achyutnar/therapyDeviceFYP/Component Dimension.xlsx

(All Dimensions mentioned in mm)
Component | Length | Width | Height | Robu
Battery | 70 | 40 | 25 | Li-Ion Battery (https://robu.in/product/18650-li-ion-2500mah-7-4v-2s1p-protected-battery-pack-3c-2/)
Fabricated PCB | 70 | 50 | 2
OLED Display | 7.6 | 24.4 |  | OLED 0.91 Inch (https://robu.in/product/0-91-inch-128x32-i2c-iic-serial-blue-oled-lcd-display-module/)
Button | 6 | 6 |  | Tactile Button (https://robu.in/product/kfc-a06b-7-0-tact-switch-long-terminals-2-pin6x6x7/)
Power Button | 6 | 6 | 6 | Self Lock Switch (https://robu.in/product/self-lock-switch-kfc-5-85-8-short-head/)
Female Power Jack | Diameter : 5.5 |  |  | DC Power Jack Female (https://robu.in/product/female-2-15-5mm-for-dc-power-jack-adapter-connector-plug-for-cctv-camera/)
Female TENS Jack | Diameter : 5.5 |  |  | DC Power Jack Female (https://robu.in/product/female-2-15-5mm-for-dc-power-jack-adapter-connector-plug-for-cctv-camera/)
PTC Heater | 0 | 21 | 5 | Heating Element (https://robu.in/product/12v-ptc-heaters-heating-element-hair-dryer-accessories-curlers-heater-80-degree-celsius-air-heater/)
Vibration Motor | Diameter : 8 |  |  | Vibration motor (https://robu.in/product/erm-coin-vibration-motor-8-mm-dia-2-mm-width/)
