achyutnar/therapyDeviceFYP/Component Documentation/Nano BLE33 Rev 2/ABX00071-cad-files/Manufacturing files/BOM/Bill of Materials-NANO33BLE(ABX00071).xlsx

Fitted | Quantity | Designator | Code Arduino | Manufacturer | Part Number | Description
Fitted | 1 | C1 | 0689 | PSA Shenzen | FV21X472K102ECG | CAP CHIP 0805 4.7nF 10% 1000V X7R
Fitted | 6 | C2, C7, C8, C9, C19, C24 | A5141 | Murata | GRM155R61H104KE19D | CAP CHIP 0402 100nF 10% 50V X5R
Fitted | 4 | C3, C4, C17, C23 | 2213 | Hottech | C1608A106M250NT | CAP CHIP 0603 10uF 20% 25V X5R
Fitted | 1 | C5 | 0132 | Walsin | 0402B104K160CT | CAP CHIP 0402 100nF 10% 16V X7R
Fitted | 2 | C6, C10 | 2321 | KEMET | GRM155R71H102KA01D | CAP CHIP 0402 1nF 10% 50V X7R
Not Fitted | 0 | C11, C12, C21 | A5141 | Murata | GRM155R61H104KE19D | CAP CHIP 0402 100nF 10% 50V X5R
Not Fitted | 0 | C13 | 0165 | Hottech | C1005B103K500NT | CAP CHIP 0402 10nF 10% 50V X7R
Not Fitted | 0 | C14 | 0833 | Hottech | C1005A475M6R3NT | CAP CHIP 0402 4.7uF 20% 6V3 X5R
Not Fitted | 0 | C15, C16, C25 | 0133 | Samsung Electro-Mechanics | CL05A105KP5NNNC | CAP CHIP 0402 1uF 10% 10V X5R
Fitted | 1 | C20 | 0137 | Walsin | 0402N220J500CT | CAP CHIP 0402 22pF 5% 50V C0G
Fitted | 1 | C22 | 0133 | Samsung Electro-Mechanics | CL05A105KP5NNNC | CAP CHIP 0402 1uF 10% 10V X5R
Fitted | 1 | D1 | 2209 | Nexperia | PRTR5V0U2X,215 | TVS ARRAY 4LIN.8kV 1pF SOT143B
Fitted | 1 | D2 | 2208 | Nexperia | PMEG6020AELRX | DIODE SCHOTTKY SMD 2A 60V SOD123FL
Fitted | 1 | DL1 | 2243 | Kingbright | KPT-1608YC | LED SMD 0603 GIA588 8mcd 120^
Fitted | 1 | DL2 | 2204 | Broadcom | HSMG-C190 | LED SMD 0603 GREEN/568 15mcd 120^
Fitted | 1 | DL3 | A5469 | ROHM Semiconductor | SMLP34RGB2W3 | LED RGB DIFFUSED PICOLED SMD
Fitted | 1 | J1 | 2219 | Hirose | ZX62-AB-5PA(31) | CONN USB MICRO F/90^ SMD TipoAB 5x1
Not Fitted | 0 | JP2 | 0646 |  |  | CONN THD SOCKET F/1/D 15V JANALOG NANO-TYPE CASTELLATED
Not Fitted | 0 | JP3 | 0646 |  |  | CONN THD SOCKET F/1/D 15V JDIGITAL NANO-TYPE CASTELLATED
Fitted | 1 | L1 | A5482 | Murata | BLM18EG101TN1D | FERRITE SMD 0603 45mOHM 2A
Fitted | 1 | L2 | I0045 | Taiyo Yuden | MAKK2016T3R3M | IND CHIP 0806 3.3 uH 20% 1.2A
Fitted | 1 | PB1 | 0173 | Switronic | IT-1185AP1C-160G-GTR | PUSHBUTTON WHITE NO ANCHORS
Fitted | 1 | Q1 | 2368 | Diodes Inc. | 2N7002T-7-F | MOSFET N-CH 60V 115mA SOT523
Fitted | 1 | R1 | 0139 | Vishay | CRCW04021M00FKED | RES CHIP 0402 1M 1% 1/16W
Fitted | 2 | R2, R3 | 2229 | Vishay | CRCW0402330RJNED | RES CHIP 0402 330R 5% 1/16W
Not Fitted | 0 | R4, R5 | 2196 | YAGEO | RC0402FR-074K7L | RES CHIP 0402 4k7 1% 1/16W
Fitted | 2 | R6, R9 | R0070 | Vishay | CRCW0402976KFKED | RES CHIP 0402 976k 1% 1/16W
Fitted | 3 | R7, R11, R12 | 0140 | Vishay | CRCW04021K00FKEDC | RES CHIP 0402 1k 1% 1/16W
Fitted | 1 | R8 | 2334 | Vishay | CRCW0402220KFKED | RES CHIP 0402 220k 1% 1/16W
Fitted | 2 | R13, R14 | 2196 | YAGEO | RC0402FR-074K7L | RES CHIP 0402 4k7 1% 1/16W
Not Fitted | 0 | R15 | 0468 | YAGEO | RC0402FR-0722RL | RES CHIP 0402 22R 1% 1/16W
Fitted | 4 | SJ1, SJ2, SJ3, SJ5 | This is not a component |  |  | Solder Jumper 0805 THIS IS NOT A COMPONENT
Fitted | 1 | SJ4 |  |  |  | Solder Jumper shorted pads. This is not a component
Fitted | 1 | U1 | NINA-B306 | UBlox | NINA-B306 | MODULE BLE 5.0 STAND ALONE nRF52
Fitted | 1 | U2 | U0217 | Bosch Sensortec | BMI270 | IC IMU 6 AXIS 14VFLGA pin to pin alternative to LSM6DSOXTR
Not Fitted | 0 | U3 | A5470 | ST Microelectronics | MP34DT06JTR | SENS MEMS AUDIO OMNIDIRECTIONAL
Not Fitted | 0 | U4 | U0034 | Microchip | ATECC608A-MAHDA-T | IC AUTHENTICATION CHIP UDFN8
Not Fitted | 0 | U5 | A5475 | Broadcom | APDS-9960 | IC SENS OPT 560NM AMBIENT MODULE APDS-9960
Fitted | 1 | U6 | U0072 | Monolithic Power Systems | MP2322GQH | IC STEP DOWN CONV 1A 22V QFN8
Fitted | 1 | U7 | U0153 | Bosch Sensortec | BMM150 | IC SENSOR 3-AXIS GEOMAGNETIC
Not Fitted | 0 | U8 | U0253 | Renesas | HS3003 | IC PRESSURE AND TEMPERATURE SENSOR 6-LGA
Not Fitted | 0 | U9 | A5390 | ST Microelectronics | LPS22HBTR | SENSOR PRESSURE 3.77 PSI ~ 18.27 PSI (26 kPa ~ 126 kPa) Absolute 24 b 10-WFLGA
