achyutnar/therapyDeviceFYP/Research Papers and Documents/Device Controller App Design.pdf

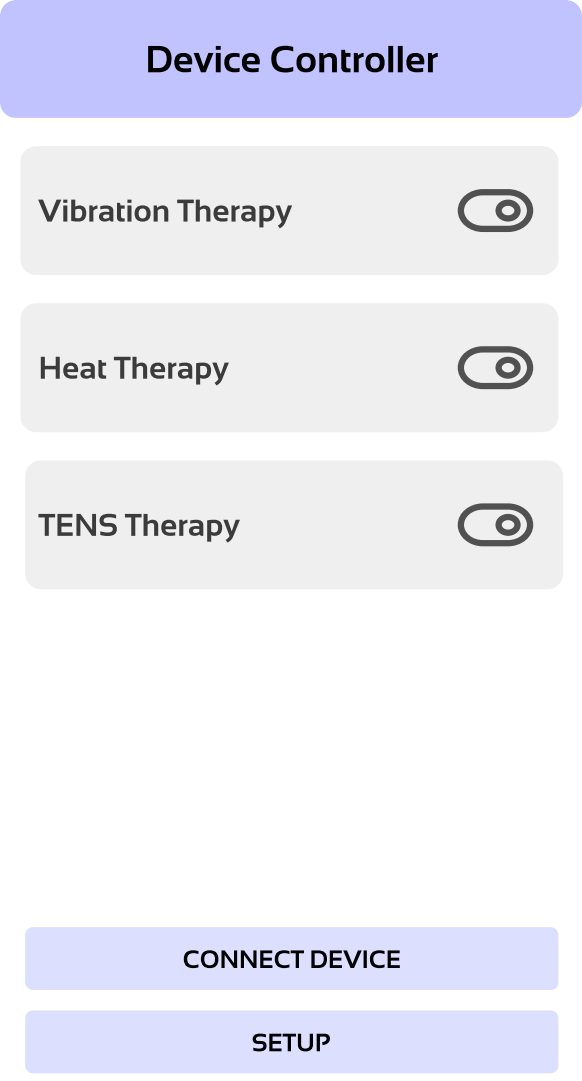
[picture p39: page 1]
Device Controller; CONNECT DEVICE; SETUP

## Device Setup

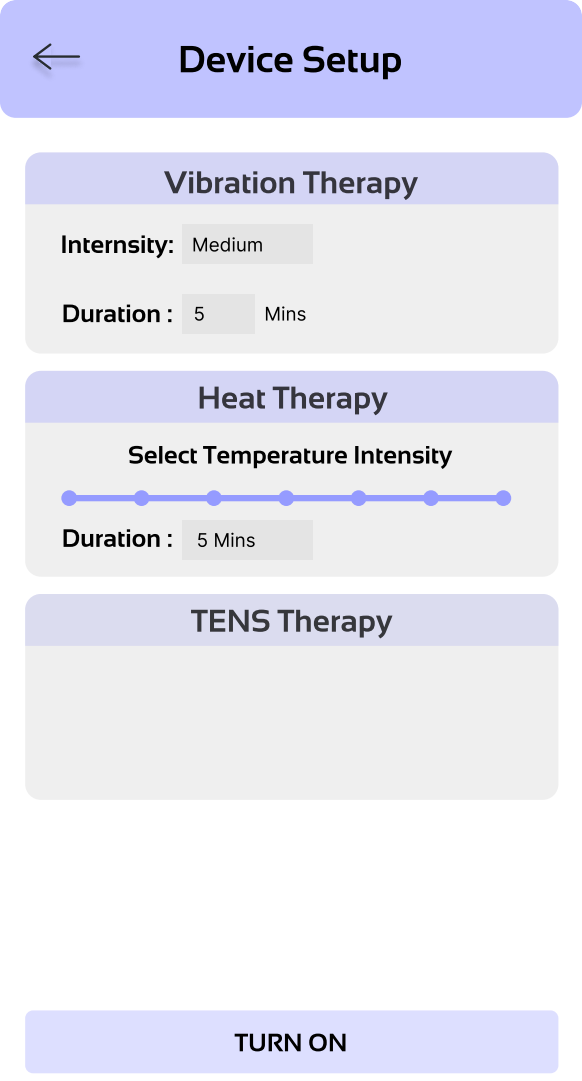
[picture p40: page 2]
TURN ON; Mins; Duration :; 5 Mins; Internsity:; Medium

Select Temperature Intensity
