achyutnar/therapyDeviceFYP/Research Papers and Documents/The emerging role of focal muscle vibration in rehabilitation of neurological.pdf

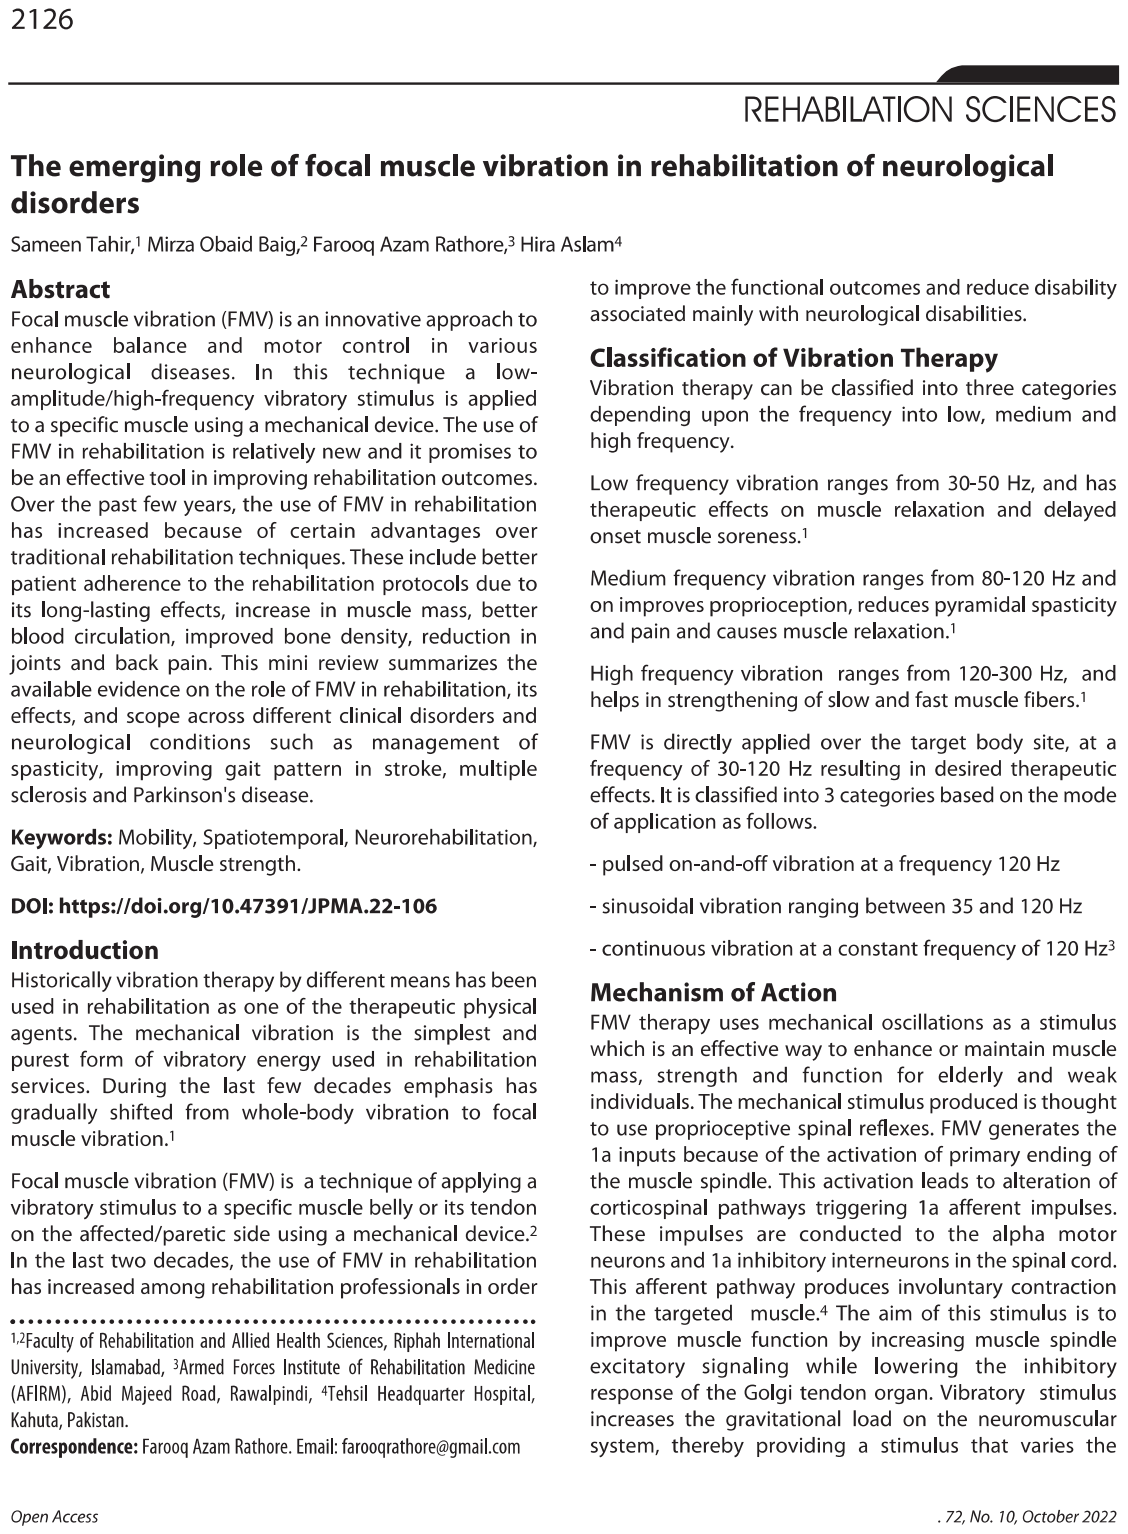
[picture p45: page 1]

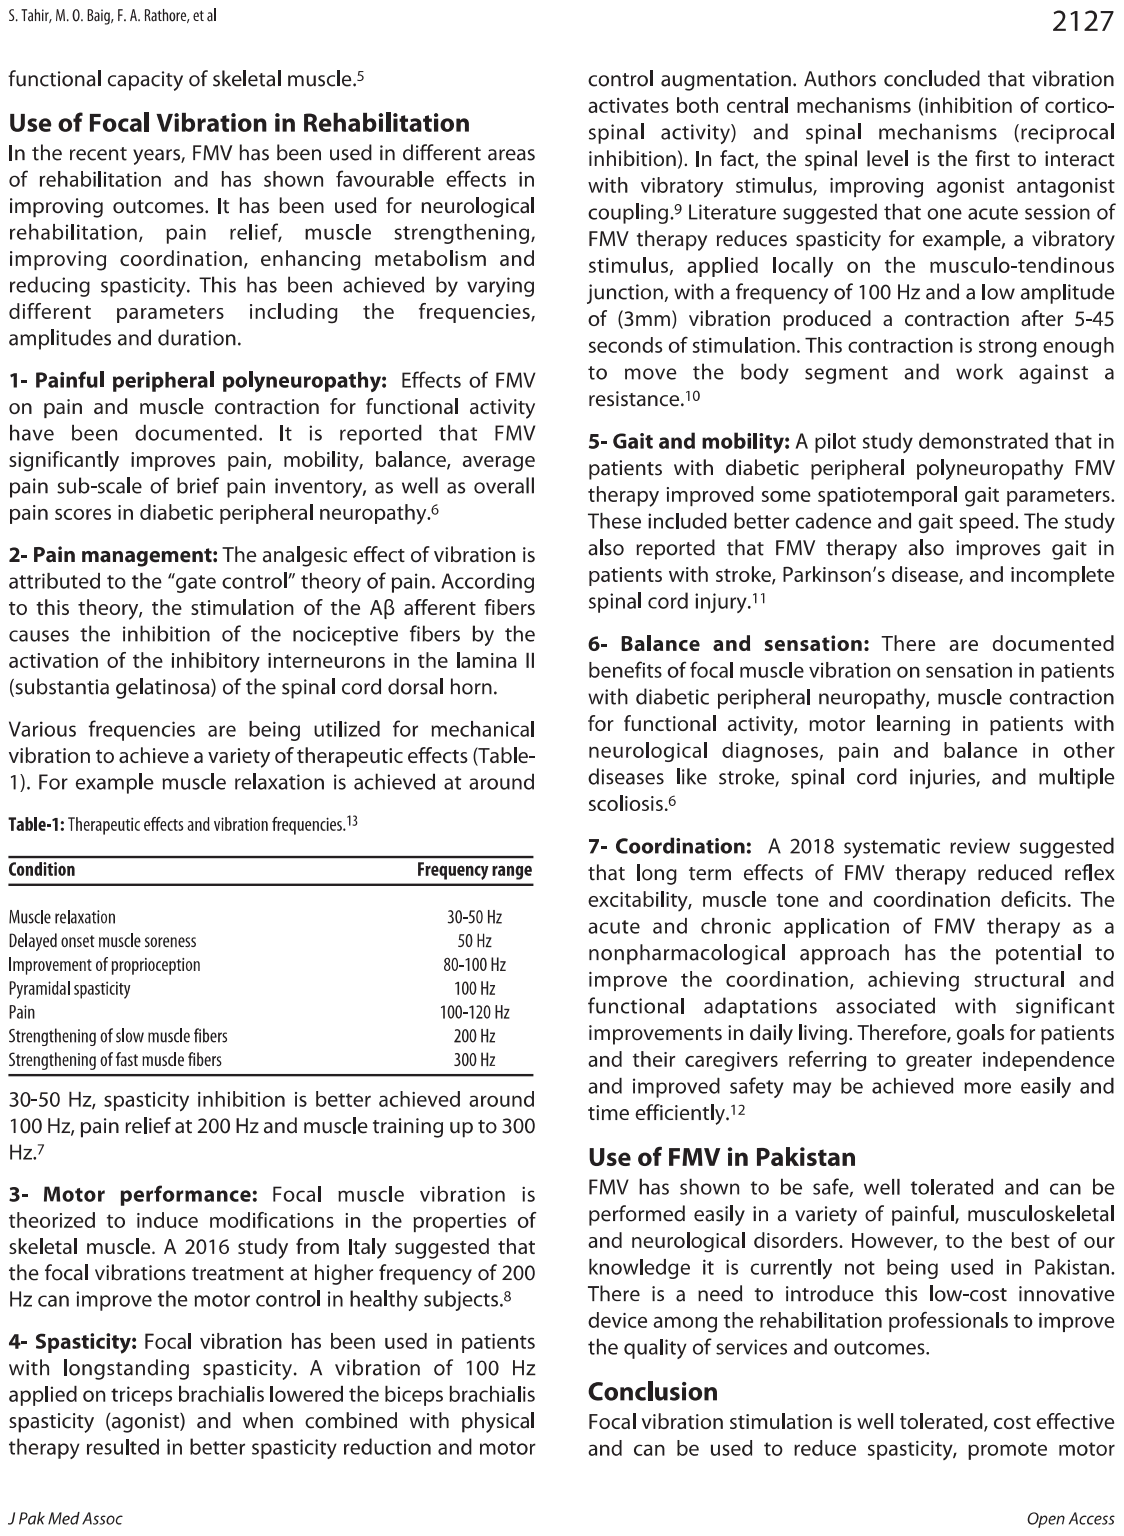
[picture p46: page 2]

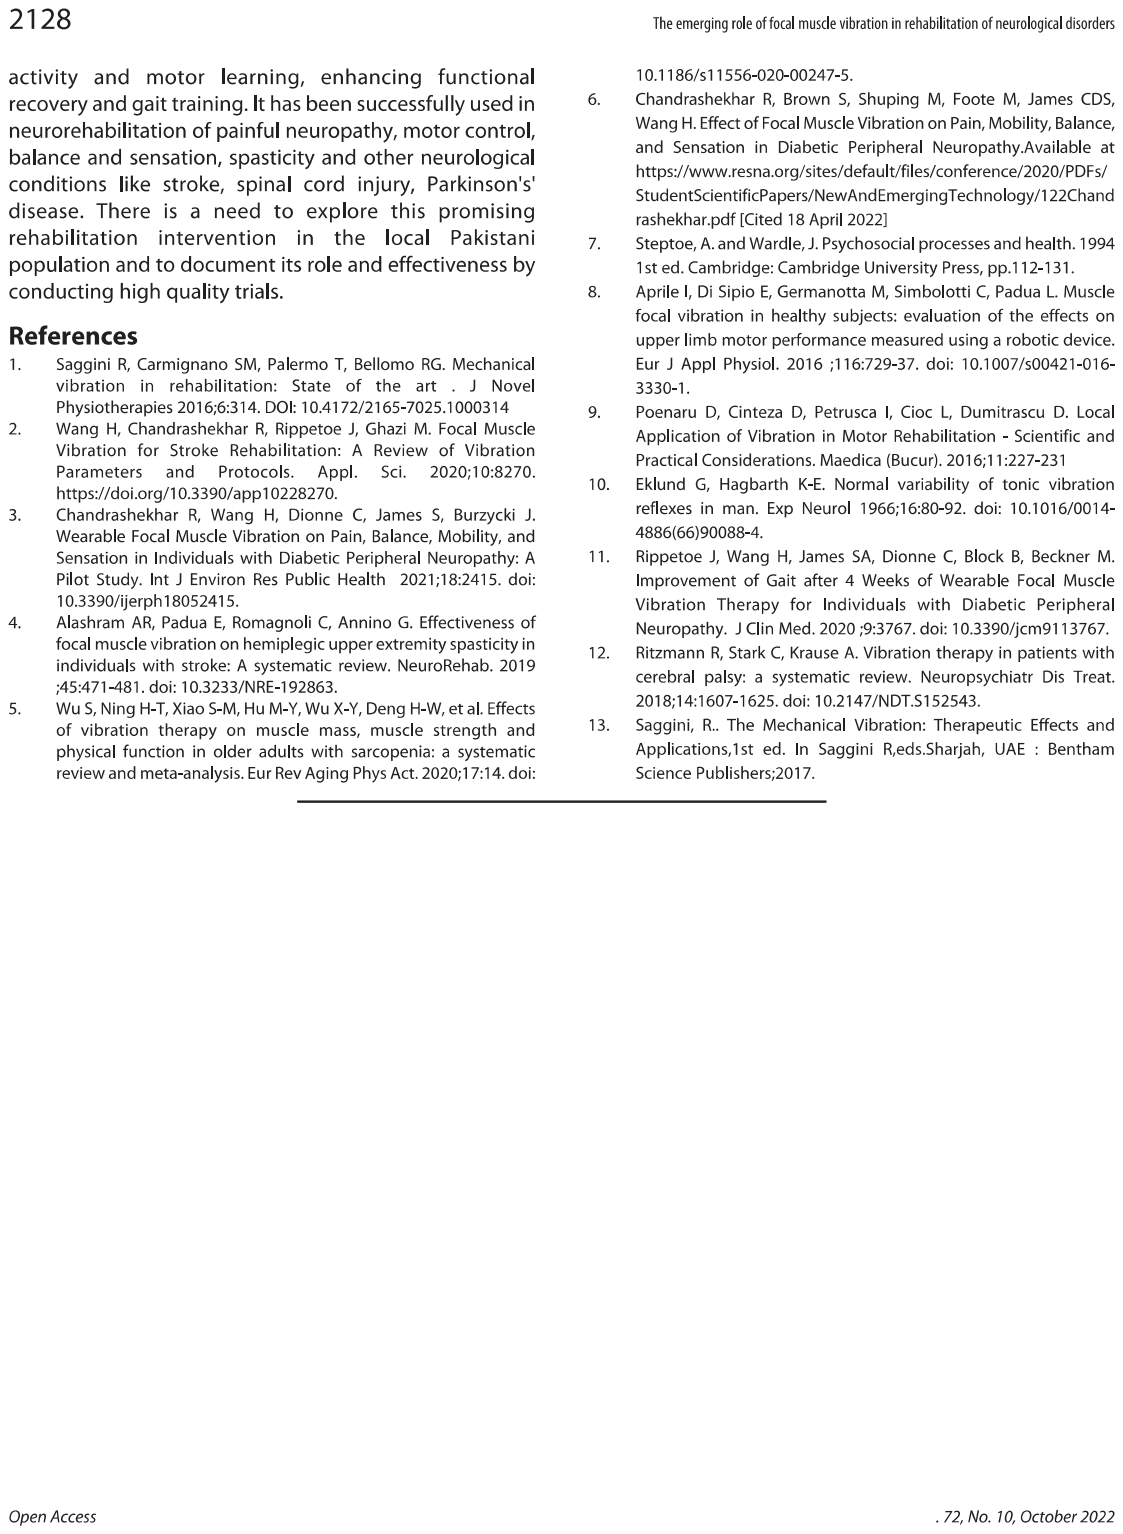
[picture p47: page 3]
