achyutnar/therapyDeviceFYP/(list of files, drawings)

Other design files:
Component Documentation/Nano BLE33 Rev 2/ABX00071-cad-files/Altium files/NANO33BLE.PcbDoc
Component Documentation/Nano BLE33 Rev 2/ABX00071-cad-files/Altium files/NANO33BLE.SchDoc
Component Documentation/Nano BLE33 Rev 2/ABX00071-cad-files/Altium files/NANOBLE.PrjPcb
