achyutnar/therapyDeviceFYP/PCB Design/VibAndHeat_Version1/VibAndHeat_Version1.kicad_pcb

## KiCad design PCB Design/VibAndHeat_Version1/VibAndHeat_Version1.kicad_pcb (2025-05-12)

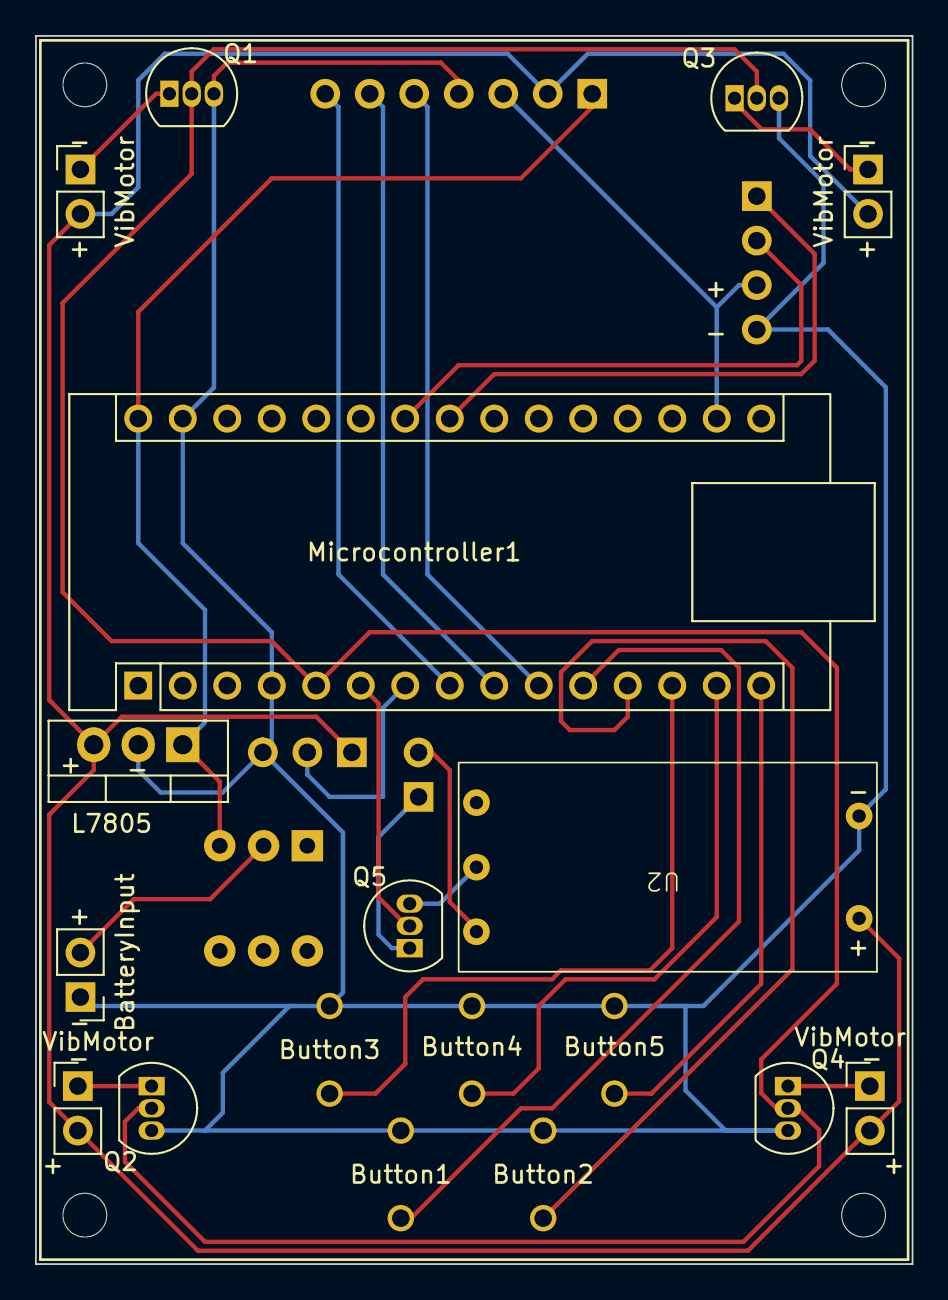
[picture p48: board VibAndHeat_Version1.kicad_pcb from above]

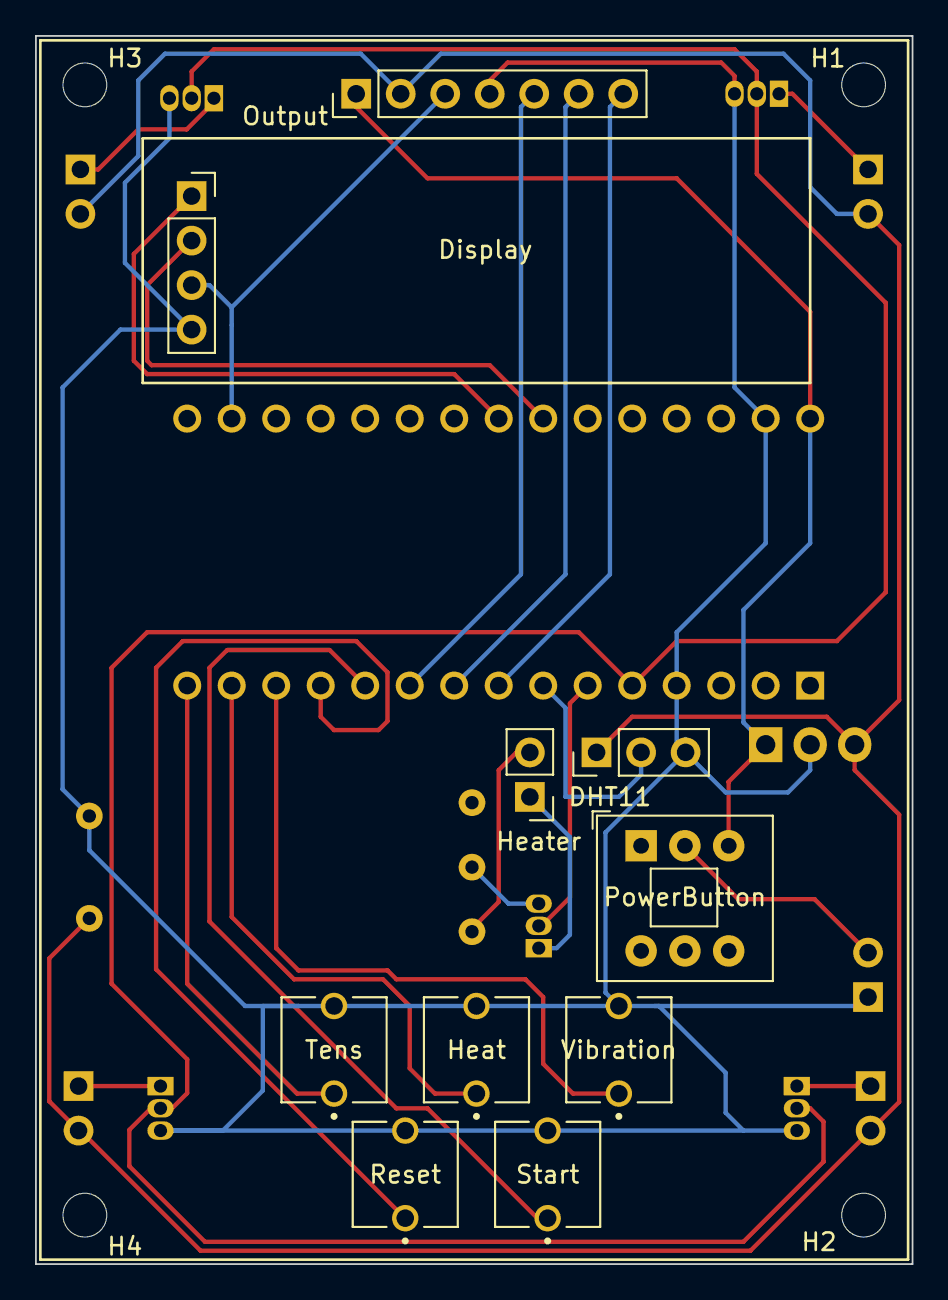
[picture p49: board VibAndHeat_Version1.kicad_pcb from below]

Board: 2 copper layers, 50.0 x 70.1 mm, 27 parts (14 on the bottom side), 25 nets.

Parts:
Button1: Start; Button_Push_2pin
Button2: Reset; Button_Push_2pin
Button3: Vibration; Button_Push_2pin
Button4: Heat; Button_Push_2pin
Button5: Tens; Button_Push_2pin
H1, H2, H3, H4: MountingHole; MountingHole_2.5mm
J1, J2, J3, J4: VibMotor; PinHeader_1x02_P2.54mm_Vertical
J5: Heater; PinHeader_1x02_P2.54mm_Vertical
J6: BatteryInput; PinHeader_1x02_P2.54mm_Vertical
J7: Display; PinSocket_1x04_P2.54mm_Vertical
J8: Output; PinHeader_1x07_P2.54mm_Vertical
Microcontroller1: Nano BLE33; Arduino_Nano
Q1, Q2, Q3, Q4, Q5: 2N2222; TO-92_Inline
SW1: PowerButton; SW_Push_2P2T_Toggle_CK_PVA2OAH5xxxxxxV2
U1: DHT11; PinHeader_1x03_P2.54mm_Vertical
U2: Step_up_Convertor_12v
U3: L7805; TO-220-3_Vertical

Connections:
GND: Button1.2, Button2.2, Button3.2, Button4.2, Button5.2, J6.1, J7.4, J8.4, Microcontroller1.4 (GND), Microcontroller1.29 (GND), Q1.3 (C), Q2.3 (C), Q3.3 (C), Q4.3 (C), U1.3 (GND), U2.2 (GND1), U3.2 (GND)
HT-Heater: Microcontroller1.6 (D3), Q5.2 (B)
HT-Sensor: Microcontroller1.7 (D4), U1.2 (IO)
Input_5v: J1.2, J2.2, J3.2, J4.2, J8.2, U1.1 (VCC), U2.1 (VIN), U3.3 (OUT)
Input_7v4: J8.1, Microcontroller1.30 (VIN), SW1.3 (C), U3.1 (IN)
unnamed: J1.1, Q1.1 (E)
unnamed: J2.1, Q2.1 (E)
unnamed: J3.1, Q3.1 (E)
unnamed: J4.1, Q4.1 (E)
unnamed: J5.1, Q5.1 (E)
unnamed: J5.2, U2.3 (VOUT+)
unnamed: J6.2, SW1.2 (B)
unnamed: Q5.3 (C), U2.4 (GND2)
Output-3v3: J7.3, J8.3, Microcontroller1.17 (3V3)
SCL_Display: J7.2, Microcontroller1.24 (A5)
SDA_Display: J7.1, Microcontroller1.23 (A4)
SW-Heat: Button4.1, Microcontroller1.14 (D11)
SW-Reset: Button2.1, Microcontroller1.12 (D9)
SW-Start: Button1.1, Microcontroller1.11 (D8)
SW-Tens: Button5.1, Microcontroller1.15 (D12)
SW-Vibration: Button3.1, Microcontroller1.13 (D10)
TT-Enable: J8.7, Microcontroller1.8 (D5)
TT-Input1: J8.6, Microcontroller1.9 (D6)
TT-Input2: J8.5, Microcontroller1.10 (D7)
VT-Motor: Microcontroller1.5 (D2), Q1.2 (B), Q2.2 (B), Q3.2 (B), Q4.2 (B)
