achyutnar/therapyDeviceFYP/Component Documentation/Nano BLE33/ABX00030-cad-files/NANO33BLE_V4.0.brd

## EAGLE design Component Documentation/Nano BLE33/ABX00030-cad-files/NANO33BLE_V4.0.brd (2025-05-12)

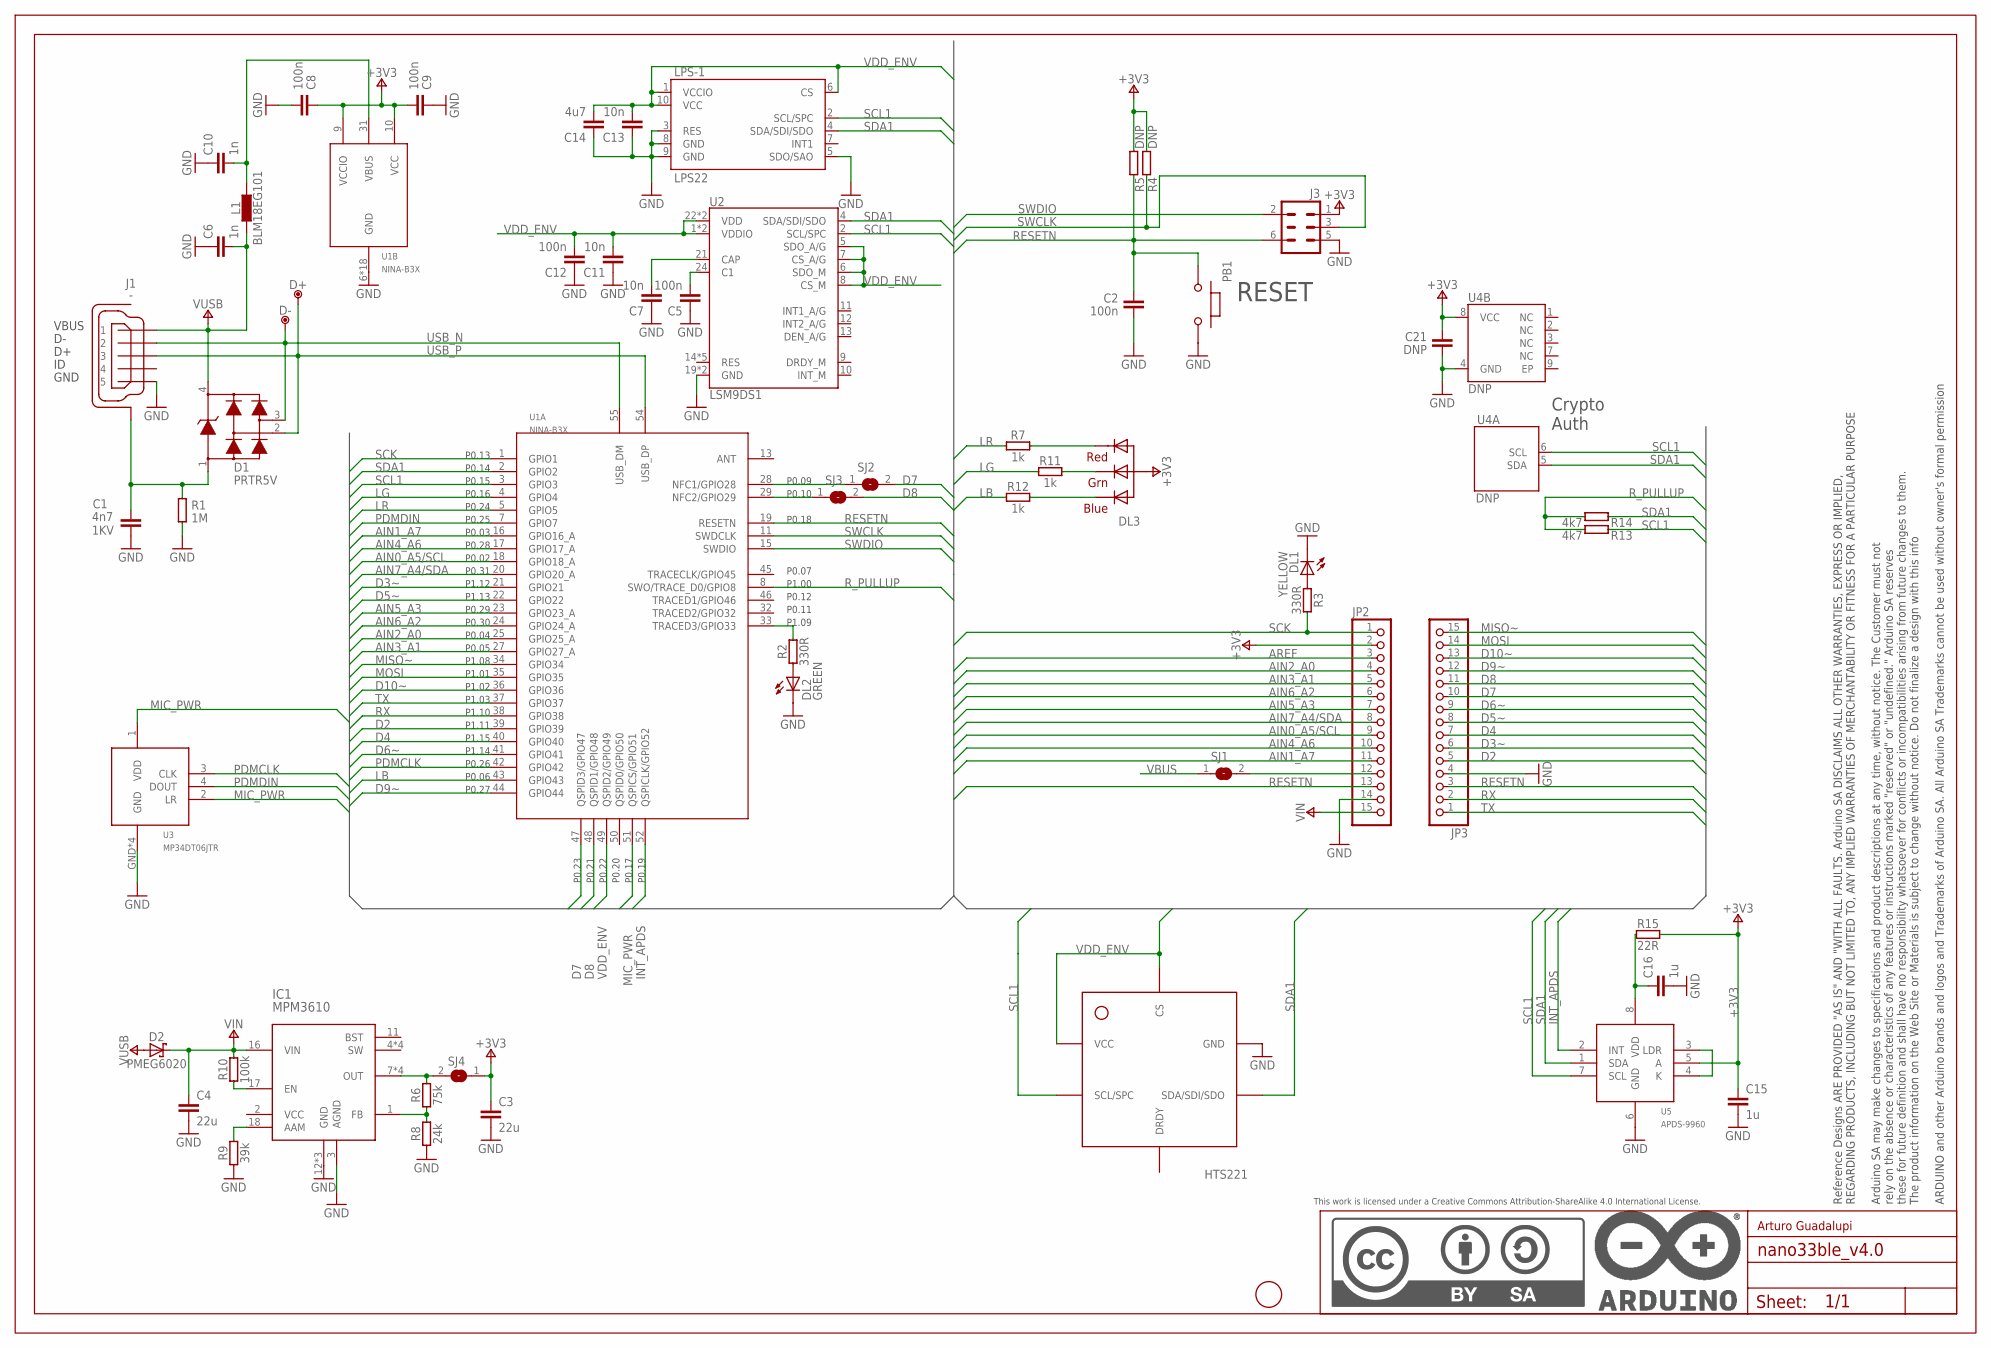
[picture p50: schematic NANO33BLE_V4.0.sch]

Parts:
C1: 4n7; 0805-R2013X50N; VOLTAGE 1KV
C2, C5, C8, C9, C12: 100n; 0402-1005X55N
C3, C4: 22u; 0805-R2013X50N
C6, C10: 1n; 0402-1005X55N
C7, C11, C13: 10n; 0402-1005X55N
C14: 4u7; 0402-1005X55N
C15, C16: 1u; 0402-1005X55N
C21: DNP; 0402-1005X55N
D1: PRTR5V; SOT190P230X110-4N
D2: PMEG6020; SODFL3517X110N
D+: DNP; TP-1.00MM
D-: DNP; TP-1.00MM
DL1: YELLOW; LEDC1608X80N-AK
DL2: GREEN; LEDC1608X80N-AK
DL3: -; SMLP34RGB2W
FD1: DNP; FD-1-1.5
FRAME1: DNP; FRAME
HS-1: HTS221
IC1: MPM3610
J1: -; ZX62-AB-5PA
J3: DNP; 2X03-TP1
JP2, JP3: PINHD-1X15-CASTELLATED; 1X15-CASTELL
L1: BLM18EG101; 0603-1608X90N
LPS-1: LPS22; LPS22H
PB1: TACTILE3NO_SH; C&K_PTS820_NO_SH
R1: 1M; 0402-1005X55N
R2, R3: 330R; 0402-1005X55N
R4, R5: DNP; 0402-1005X55N
R6: 75k; 0402-1005X55N
R7, R11, R12: 1k; 0402-1005X55N
R8: 24k; 0402-1005X55N
R9: 39k; 0402-1005X55N
R10: 100k; 0402-1005X55N
R13, R14: 4k7; 0402-1005X55N
R15: 22R; 0402-1005X55N
SJ1, SJ2, SJ3, SJ4: DNP; SJ
U1: NINA-B3X
U2: LSM9DS1; LSM9DS1_TEMP_LGA24-8X4
U3: MP34DT06JTR; HCLGA
U4: DNP; SON50P300X200X60-9N-EP160X140
U5: APDS-9960; APDS9960

Connections:
+3V3: C3.1, C8.1, C9.2, C15.1, C21.1, DL3.1 (A), J3.1, JP2.2, R4.2, R5.2, R15.2, SJ4.1, U1.9 (VCCIO), U1.10 (VCC), U4.8 (VCC), U5.5 (A)
AIN0_A5/SCL: JP2.9, U1.18 (GPIO18_A)
AIN1_A7: JP2.11, U1.16 (GPIO16_A)
AIN2_A0: JP2.4, U1.25 (GPIO25_A)
AIN3_A1: JP2.5, U1.27 (GPIO27_A)
AIN4_A6: JP2.10, U1.17 (GPIO17_A)
AIN5_A3: JP2.7, U1.23 (GPIO23_A)
AIN6_A2: JP2.6, U1.24 (GPIO24_A)
AIN7_A4/SDA: JP2.8, U1.20 (GPIO20_A)
AREF: JP2.3
D2: JP3.5, U1.39 (GPIO39)
D3~: JP3.6, U1.21 (GPIO21)
D4: JP3.7, U1.40 (GPIO40)
D5~: JP3.8, U1.22 (GPIO22)
D6~: JP3.9, U1.41 (GPIO41)
D7: JP3.10, SJ2.2, U1.47 (QSPID3/GPIO47)
D8: JP3.11, SJ3.2, U1.48 (QSPID1/GPIO48)
D9~: JP3.12, U1.44 (GPIO44)
D10~: JP3.13, U1.36 (GPIO36)
GND: C1.2, C2.2, C3.2, C4.2, C5.1, C6.1, C7.1, C8.2, C9.1, C10.1, C11.1, C12.1, C13.1, C14.1, C15.2, C16.2, C21.2, DL1.C, DL2.C, HS-1.P$5.GND (GND), IC1.3 (AGND), IC1.12 (GND), IC1.13 (GND), IC1.14 (GND), J1.5, J3.5, JP2.14, JP3.4, LPS-1.3 (RES), LPS-1.5 (SDO/SAO), LPS-1.8 (GND), LPS-1.9 (GND), PB1.6 (2), R1.1, R8.1, R9.1, U1.6 (GND), U1.12 (GND), U1.14 (GND), U1.26 (GND), U1.30 (GND), U1.53 (GND), U1.GND@1 (GND), U1.GND@2 (GND), U1.GND@3 (GND), U1.GND@4 (GND), U1.GND@5 (GND), U1.GND@6 (GND), U1.GND@7 (GND), U1.GND@8 (GND), U1.GND@9 (GND), U1.GND@10 (GND), U1.GND@11 (GND), U1.GND@12 (GND), U2.19 (GND), U2.20 (GND), U3.GND, U3.GND@2 (GND), U3.GND@3 (GND), U3.GND@4 (GND), U4.4 (GND), U5.6 (GND)
INT_APDS: U1.52 (QSPICLK/GPIO52), U5.2 (INT)
LB: R12.1, U1.43 (GPIO43)
LG: R11.1, U1.4 (GPIO4)
LR: R7.1, U1.5 (GPIO5)
MIC_PWR: U1.51 (QSPICS/GPIO51), U3.1 (VDD), U3.2 (LR)
MISO~: JP3.15, U1.34 (GPIO34)
MOSI: JP3.14, U1.35 (GPIO35)
unnamed: C1.1, D1.1, J1.6 (SH), J1.7 (SH), J1.8 (SH), J1.9 (SH), J1.10 (SH), J1.11 (SH), R1.2
unnamed: DL2.A, R2.1
unnamed: DL1.A, R3.1
unnamed: C5.2, U2.24 (C1)
unnamed: IC1.1 (FB), R6.1, R8.2
unnamed: IC1.18 (AAM), R9.2
unnamed: IC1.17 (EN), R10.1
unnamed: C7.2, U2.21 (CAP)
unnamed: U5.3 (LDR), U5.4 (K)
unnamed: R2.2, U1.33 (TRACED3/GPIO33)
unnamed: DL3.3 (BLUE_C), R12.2
unnamed: DL3.2 (RED_C), R7.2
unnamed: DL3.4 (GREEN_C), R11.2
unnamed: JP2.12, SJ1.2
unnamed: C16.1, R15.1, U5.8 (VDD)
unnamed: IC1.7 (OUT), IC1.8 (OUT), IC1.9 (OUT), IC1.20 (OUT), R6.2, SJ4.2
NFC1: SJ2.1, U1.28 (NFC1/GPIO28)
NFC2: SJ3.1, U1.29 (NFC2/GPIO29)
PDMCLK: U1.42 (GPIO42), U3.3 (CLK)
PDMDIN: U1.7 (GPIO7), U3.4 (DOUT)
RESETN: C2.1, J3.6, JP2.13, JP3.3, PB1.5 (1), R5.1, U1.19 (RESETN)
RX: JP3.2, U1.38 (GPIO38)
R_PULLUP: R13.2, R14.2, U1.8 (SWO/TRACE_D0/GPIO8)
SCK: JP2.1, R3.2, U1.1 (GPIO1)
SCL1: HS-1.P$2.SCL/SPC (SCL/SPC), LPS-1.2 (SCL/SPC), R13.1, U1.3 (GPIO3), U2.2 (SCL/SPC), U4.6 (SCL), U5.7 (SCL)
SDA1: HS-1.P$4.SDA/SDI/SDO (SDA/SDI/SDO), LPS-1.4 (SDA/SDI/SDO), R14.1, U1.2 (GPIO2), U2.4 (SDA/SDI/SDO), U4.5 (SDA), U5.1 (SDA)
SWCLK: J3.3, R4.1, U1.11 (SWDCLK)
SWDIO: J3.2, U1.15 (SWDIO)
TX: JP3.1, U1.37 (GPIO37)
USB_N: D1.3, D-.X, J1.2, U1.55 (USB_DM)
USB_P: D1.2, D+.X, J1.3, U1.54 (USB_DP)
VBUS: C10.2, L1.2, SJ1.1, U1.31 (VBUS)
VDD_ENV: C11.2, C12.2, C13.2, C14.2, HS-1.P$1.VDD (VCC), HS-1.P$6.CS (CS), LPS-1.1 (VCCIO), LPS-1.6 (CS), LPS-1.10 (VCC), U1.49 (QSPID2/GPIO49), U2.1 (VDDIO), U2.3 (VDDIO), U2.5 (SDO_A/G), U2.6 (SDO_M), U2.7 (CS_A/G), U2.8 (CS_M), U2.22 (VDD), U2.23 (VDD)
VIN: C4.1, D2.C, IC1.16 (VIN), JP2.15, R10.2
VUSB: C6.2, D1.4, D2.A, J1.1, L1.1

Notes on the sheet:
RESET
Crypto Auth
Arturo Guadalupi
HTS221

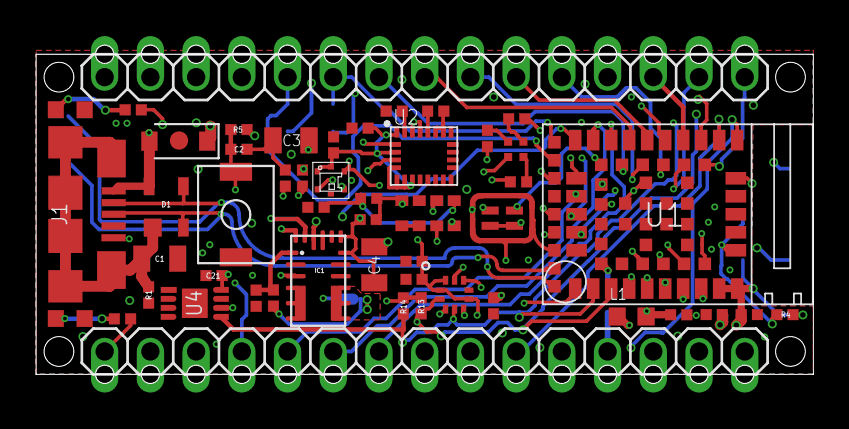
[picture p51: board NANO33BLE_V4.0.brd from above]

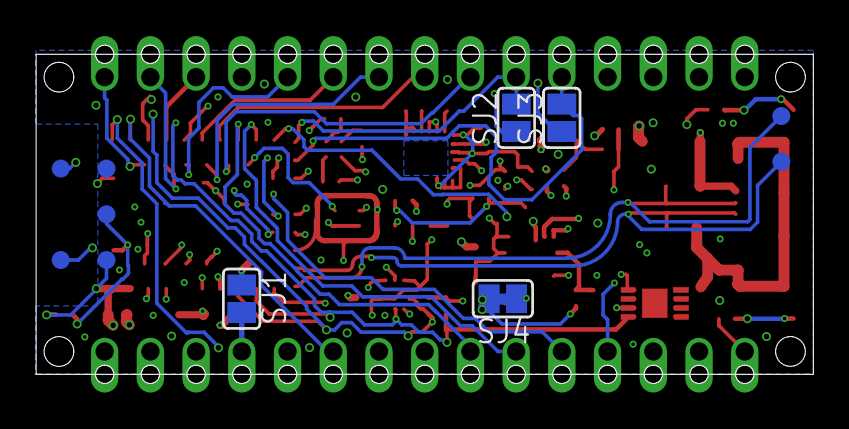
[picture p52: board NANO33BLE_V4.0.brd from below]

Board: 4 copper layers, 43.2 x 17.8 mm, 59 parts (4 on the bottom side), 61 nets.
