achyutnar/therapyDeviceFYP/Testing Codes/tensV2.ino

// Motor A connections
int enA = 7;
int in1 = 6;
int in2 = 5;

void setup() 
{
	pinMode(enA, OUTPUT);
	pinMode(in1, OUTPUT);
	pinMode(in2, OUTPUT);
	
	// Turn off motors - Initial state
	digitalWrite(in1, LOW);
	digitalWrite(in2, LOW);
}

void loop() 
{
	// directionControl();
  digitalWrite(enA, HIGH);
	digitalWrite(in1, HIGH);
	digitalWrite(in2, LOW);
	delay(200);
	
	// Now change motor directions
	digitalWrite(in1, LOW);
	digitalWrite(in2, HIGH);
	delay(200);
  delay(1000);
	// speedControl();
	// delay(1000);
}

// This function lets you control spinning direction of motors
void directionControl() 
{
	// Set motors to maximum speed
	// For PWM maximum possible values are 0 to 255
	analogWrite(enA, 255);

	// Turn on motor A & B
	digitalWrite(in1, HIGH);
	digitalWrite(in2, LOW);
	delay(200);
	
	// Now change motor directions
	digitalWrite(in1, LOW);
	digitalWrite(in2, HIGH);
	delay(200);
	
	// Turn off motors
	digitalWrite(in1, LOW);
	digitalWrite(in2, LOW);
}

// This function lets you control speed of the motors
void speedControl() 
{
	// Turn on motors
	digitalWrite(in1, LOW);
	digitalWrite(in2, HIGH);
	
	// Accelerate from zero to maximum speed
	for (int i = 0; i < 256; i++) {
		analogWrite(enA, i);
		delay(20);
	}
	
	// Decelerate from maximum speed to zero
	for (int i = 255; i >= 0; --i) {
		analogWrite(enA, i);
		delay(20);
	}
	
	// Now turn off motors
	digitalWrite(in1, LOW);
	digitalWrite(in2, LOW);
}
