achyutnar/therapyDeviceFYP/(commit log)

2025-05-12 Files added
    [Bill of Materials-NANO33BLE(ABX00071).xlsx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]
2025-05-13 Component Dimension file added
    [Component Dimension.xlsx]
2025-05-13 Update Component Dimension.xlsx
    [Component Dimension.xlsx]
