achyutnar/therapyDeviceFYP/(notices)

Notices in the files:
Component Documentation/Nano BLE33/ABX00030-cad-files/NANO33BLE_V4.0.brd:
Copyright (c) 2016-2017 Arduino LLC. All right reserved. EAGLE Design Rules
parts and their libraries:
Arduino-utility: This work is licensed under a Creative Commons Attribution-ShareAlike 4.0 International License.
Arduino-ucs: Copyright (c) 2016-2017 Arduino LLC. All right reserved.
